BroncoSpace-BILLEE/billee-hardware-2026/BILLEE_Rover_Control_Module_V1/PDB_Engineering_Requirements_and_Design_Guide_Rev_H.docx

BILLEE RCM Power Distribution Board

Engineering Requirements and Design Guide

By Luca Lanzillotta

# Table of Contents

- 1. How to Use This Document
- 2. Locked System Requirements
- 3. System Block Diagram / Architecture
- 4. Part Selection and LCSC/JLCPCB Procurement Table
- 5. Sensor Specifications and I2C Address Map
- 6. RP2350 GPIO Allocation and Software Bindings
- 7. Connection Requirements and PCB Guidelines
- 8. KiCad Schematic Sheet Plan
- 9. Software Implications
- 10. Validation and Bring-Up Plan
- 11. Design Checklist / Assignment Rubric
- 12. Open Verification Items
- 13. References

# 1. How to Use This Document

- Use Sections 2 and 3 to learn the architecture
- Use Sections 4 through 6 to lock parts, sensors, I2C buses, I2C addresses, and GPIO usage.
- Use Sections 7 and 8 as schematic and PCB layout requirements.
- Use Sections 9 and 10 as firmware and bring-up requirements.
- Use Section 11 as the assignment checklist and review rubric.

# 2. Locked System Requirements

## 2.1 Controller Requirement

- The baseline controller shall be a bare Raspberry Pi RP2350A placed directly on the PCB.
- The schematic shall follow the Raspberry Pi RP2350 hardware design guide and the Bronco Space Lab BLVLink hardware v2.0 reference design for RP2350 support circuitry.
- The controller shall expose USB-C for USB device/programming/serial connection to the Jetson.
- The controller shall support Zephyr/F Prime development. The software baseline shall use RP2350/Raspberry Pi Pico 2 Zephyr support as the closest reference target.

## 2.2 Battery Domains

Domain | Nominal input | Input connector | Purpose
Logic/comms | 22.2 V / 6S LiPo | XT90 | Jetson, network switch, 12 V POE antenna, RP2350 housekeeping, aux output
Drivetrain | 14.4 V / 4S LiPo | XT90 | Six independently gated drive motor-controller outputs
Arm/science | 22.2 V / 6S LiPo | XT90/XT90 | Independent ARM and SCIENCE gated outputs

## 2.3 Logic/Comms Requirements

- Jetson, network switch, antenna/POE, and RP2350 housekeeping shall come up automatically when the logic input is present and E-stop is not asserted.
- The POE/antenna module accepts up to 24 V input; it shall be powered directly from the 22.2 V logic rail downstream of its load switch (Note: a freshly charged 6S pack can briefly exceed 24 V (up to ~25.2 V at full charge) before settling under load)
- Logic-side user outputs shall use robust screw terminal blocks/xt60s unless a specific load requires a different connector.
- The aux output shall be a 12 V, always-on regulator output shared with the network switch.
- The RP2350 shall be powered from onboard housekeeping power, not from Jetson USB. Jetson USB is just for serial connection.

## 2.4 Drivetrain Requirements

- The drivetrain shall use six independent high-side MOSFET branches, one per motor-controller output.
- Each drivetrain branch shall use one IPT007N06N high-power N-channel MOSFET.
- Each drivetrain branch shall be power sequenced using one dedicated native RP2350 DRIVE_EN_x GPIO.
- Each DRIVE_EN_x signal shall pass through the GPIO buffer and E-stop gate before reaching the gate-driver input.
- Each drivetrain branch shall include one INA780x I2C current/voltage/power monitor after the MOSFET switch.
- Each drivetrain branch output shall use a horizontal through-hole XT60 connector

## 2.5 Arm/Science Requirements

- The arm/science domain shall be split into two independent rails: ARM and SCIENCE.
- The ARM and SCIENCE rail shall use the same MOSFET + gate driver + INA780x pattern as the drivetrain branches.
- ARM_EN and SCIENCE_EN shall be independent native RP2350 GPIO outputs to power sequence.
- ARM_EN and SCIENCE_EN shall pass through the GPIO buffer and E-stop gate before reaching the gate-driver inputs.

## 2.6 E-stop Requirements

- The PDB shall expose a two-pin screw terminal for the external E-stop/enable switch.
- The switch is normally closed, pulling the ESTOP AND gate input HIGH on idle, this means that when the ESTOP is twisted, it opens, and the integrated pull down resistor pulls the AND gate low.
- When the switch is activated (switch opens), all functional outputs aside from the logic subsystem shall be off. This is so we can still communicate to the system in case of a subsystem fault.
- E_STOP_OK shall be routed to every controlled output enable gate.
- Software high-power-disable exists for Drive/Science/Arms, but logic is never gated.

## 2.7 GPIO and Control Requirements

- All RP2350-controlled output GPIO shall pass through TXS0108EPWR GPIO buffers (used here as straight 3.3V-to-3.3V buffers, VCCA=VCCB) before downstream logic.
- Buffered enable outputs shall pass through SN74LVC08APWR E-stop gates before reaching gate-driver or load-switch control inputs.
- The GPIO buffer and AND gates shall be powered from the 3.3 V housekeeping rail.
- Gate-driver logic inputs shall be compatible with the 3.3 V buffered control chain.
- Gate-driver supply requirements shall be verified from the selected driver datasheet. Do not assume the gate-driver power pin can use 3.3 V unless the selected driver explicitly supports that and still fully enhances the MOSFET.

# 3. System Block Diagram / Architecture

## 3.1 Top-Level System Tree

PDB
|
|-- 22.2 V LOGIC/COMMS INPUT (6S LiPo, XT90)
| |-- E-stop-enabled logic bus
| |-- always-on housekeeping buck -> 3.3 V -> RP2350 + buffers + I2C logic
| |-- always-on protected/regulator path -> Jetson output

| |-- breaking off from before Jetson regulator -> 22.2V output for POE
| |-- always-on 12 V regulator path -> Network switch + Aux, 10 W load
|
|
|-- 14.4 V DRIVETRAIN INPUT (4S LiPo, XT90)
| |-- DRIVE branch 1: gate driver -> IPT007N06N -> INA780x -> horizontal XT60
| |-- DRIVE branch 2: gate driver -> IPT007N06N -> INA780x -> horizontal XT60
| |-- DRIVE branch 3: gate driver -> IPT007N06N -> INA780x -> horizontal XT60
| |-- DRIVE branch 4: gate driver -> IPT007N06N -> INA780x -> horizontal XT60
| |-- DRIVE branch 5: gate driver -> IPT007N06N -> INA780x -> horizontal XT60
| `-- DRIVE branch 6: gate driver -> IPT007N06N -> INA780x -> horizontal XT60
|
`-- 22.2 V ARM/SCIENCE INPUT (6S LiPo, 2xXT90)
|-- ARM rail: gate driver -> IPT007N06N -> INA780x -> horizontal XT60
`-- SCIENCE rail: gate driver -> IPT007N06N -> INA780x -> horizontal XT60

## 3.2 Drivetrain Branch Stack

For each branch x = 1..6:

14.4 V DRIVETRAIN BUS
|
IPT007N06N high-side N-MOSFET
|
INA780x I2C power monitor
|
through-hole XT60 output
|
motor controller

## 3.3 Drivetrain Control Stack

For each branch x = 1..6:

RP2350 DRIVE_EN_x
|
TXS0108EPWR GPIO buffer
|
SN74LVC08APWR AND gate with E_STOP_OK
|
high-side N-MOSFET gate driver input
|
IPT007N06N gate

## 3.4 Arm/Science Stack

22.2 V ARM/SCIENCE INPUT
|
|-- ARM_EN path:
| RP2350 -> buffer -> E-stop gate -> gate driver -> IPT007 -> INA780x -> ARM output
|
`-- SCIENCE_EN path:
RP2350 -> buffer -> E-stop gate -> gate driver -> IPT007 -> INA780x -> SCIENCE output

## 3.5 RP2350 Controller Stack

22.2 V logic input
|
housekeeping regulator -> 3.3 V
|
RP2350A custom controller circuit
|-- external QSPI flash
|-- 12 MHz crystal
|-- USB-C device connector
|-- SWD header
|-- BOOTSEL / RUN buttons or pads
|-- I2C0 -> TCA4307 -> high-current INA780x telemetry
|-- I2C1 -> TCA4307 -> temperature / logic telemetry
`-- native GPIO -> SN74LVC244 -> SN74LVC08 -> gate drivers

## 3.6 E-stop Stack

E-stop screw terminal:
3.3 V pull-up / bias network
|
E_STOP_NODE ---- external 2-prong E-stop switch (normally open) ---- 3.3 V logic rail when actively held closed
|
E_STOP_OK signal
|-- to RP2350 E_STOP_STATUS input
|-- to all SN74LVC08 E-stop gate inputs
`-- to full-system disconnect logic, relay, or approved competition disconnect circuit

# 4. Part Selection and LCSC/JLCPCB Procurement Table

LCSC/JLCPCB part numbers are included where verified during document generation. Stock shall still be checked at design freeze.

Function | MPN | LCSC # | Package / Style | Qty | Requirement
Controller MCU | RP2350A | C42411118 | QFN-60-EP 7x7 | 1 | Baseline controller. Enough GPIO for this architecture.
Optional controller variant | RP2350B | C42415655 | QFN-80-EP 10x10 | 0 | Optional future variant with 48 GPIO. Not baseline; LCSC currently shows not available.
External QSPI flash | W25Q128JVSIQ | C97521 | SOIC-8-208mil | 1 | Baseline external flash for RP2350A. Final capacity may be changed if Zephyr/F Prime image size requires it.
12 MHz crystal | ABM8-272-T3 | C20625731 | SMD3225-4P | 1 | Controller crystal. Match load capacitors to selected crystal and RP2350 reference design.
USB ESD protection | USBLC6-2SC6 | C7519 | SOT-23-6L | 0 | Not required: USB2 carries data only (no VBUS power delivery to a load), and D+/D- are already current-limited by 27ohm series resistors R7/R8. Decision confirmed 2026-08-07; USBLC6-2SC6 removed from baseline.
USB-C receptacle | TYPE-C-31-M-12 | C165948 | USB-C 16-pin | 1 | USB 2.0 device connection to RP2350. Verify footprint and CC resistor wiring.
GPIO buffer | TXS0108EPWR | C17206 | TSSOP-20 | 1 | Buffers all RP2350-controlled enable outputs. 8 total buffer channels; exactly covers DRIVE1-6 + ARM + SCIENCE with zero spare (AUX_22_EN/SPARE_EN removed from baseline).
E-stop AND gate | SN74LVC08APWR | C465737 | TSSOP-14 | 2 | Gates final enables with E_STOP_OK. 8 total AND channels (DRIVE1-6, ARM, SCIENCE). AUX_22_EN/SPARE_EN removed from baseline -- not implemented, no spare channels reserved.
High-side gate driver | ADI LTC7001IMSE#PBF OVLO divider intentionally set for a ~32V trip point to leave margin for a possible future higher-voltage drivetrain battery -- current 4S pack (16.8V max) has no overvoltage trip margin under this setting; accepted tradeoff, see Section 12. INP has an internal 1M-ohm pulldown to GND that holds TGDN toward TS during startup/undriven conditions -- no external MOSFET gate-source pulldown required (residual case: LTC7001 fully unpowered leaves TGDN high-Z, tracked in Section 12). | C581062 | MSOP-10-EP | 8 | One per drivetrain branch, ARM rail, and SCIENCE rail. Verify supply rail and gate drive.
Power MOSFET | IPT007N06N Since this mosfet after about ~8v reaches its “peak” current capabilities, you can set the vcc of this to be on the 12v rail output | C122552 | HSOF-8 | 8 | One per drivetrain branch, ARM rail, and SCIENCE rail.
Schottky Diode | MBR30200CT | C5270548 | TO-220AB | 8 | One per LTC7001 gate-driver channel (all 8: Drive1-6, Arm, Science). Anode to GND, cathode to LTC7001 TS pin (Top Source / switch node) -- clamps negative ringing at turn-off per ADI app guidance. Not output or reverse-polarity protection.
I2C power monitor | INA780BIDEKR | C34740774 | VQFN-15 6x6 | 8 | One per drivetrain branch, ARM rail, and SCIENCE rail.
I2C buffer | TCA4307DGKR | C880333 | VSSOP-8 | 2 min. | One per RP2350 I2C bus segment. Add more only if layout requires more physical segmentation.
Temperature sensor | MCP9808T-E/MS | C129490 | MSOP-8 | 3 min. | Logic, drivetrain, and arm/science thermal zones.
Buck regulator | LT8612EUDE#TRPBF | C462617 | QFN-28-EP 3x6 | 3 | 20v for Jetson, 3.3v for rp2350, and 12v for the POE switch + network switch. Jetson power + network switch + POE will use XT60 connectors (changed from screw terminal blocks).
XT90 Connector | XT60M | C3040689 | Through-hole power | 4 | Four battery inputs, Logic, Science, Arm, Drivetrain
XT60 connector | XT60PW-M | C98732 | Through-hole power | 13 | Six drivetrain outputs, ARM output (2x), SCIENCE output (1x), plus Jetson power, POE switch, network switch, and aux outputs (network switch and aux share one 12V rail but have separate physical XT60 pads) -- moved from KF301 screw terminals.
E-stop terminal | KF301-5.0-2P | C474881 | 2-pin screw term | 1 | Two-pin terminal for pull-to-GND E-stop sw
Screw Terminal Block | KF301-5.0-2P | C474881 | 2-pin screw terminal | 0 | Superseded -- Jetson power, POE switch, and network switch outputs now use XT60 connectors (see XT60 connector row above), not KF301 screw terminals.
Load Switch | TPS1HA08BQPWPRQ1 | C2150178 | HTSSOP-16 (PWP) | 3 | One per LT8612 buck input (3.3V/20V/12V rails), fed from the shared post-INA780-sense 22.2V logic node. Already implemented in schematic (U2/U5/U23); added here to sync BOM with as-built design. ILIM left floating -- confirmed acceptable, uses internal default current limit (~80A). SEL1=15k to GND, SNS=1k to GND selects current-sense mode; LATCH=15k to GND selects auto-retry-after-fault.

Reverse-battery protection diode

BAS21

C181108

SOT-23

1 (shared)

Ground-protection-network diode (DGND) for the TPS1HA08 cluster, per TI's TPS1HA08-Q1 recommended application circuit (Section 9.1, Ground Protection Network): placed in series between the TPS1HA08 devices' common GND reference and board GND (NOT in series with VBB), so only the eFuses' own quiescent/control current needs blocking during a reverse-battery event, not the full load current. Multiple high-side switches may share one DGND network -- U2/U5/U23 can share a single BAS21. Add RGND (4.7k-ohm typical, size against IGND abs-max rating) in parallel with DGND if any of the three drives an inductive load. NOTE: device GND will be offset from microcontroller GND by the diode's forward drop when current flows -- confirm all EN/DIA_EN/SNS/ST/SEL1/SEL2/LATCH control-pin interfaces to the RP2350 have adequate RPROT-style series resistance (15k-ohm typical per TI) for this offset. NOT YET IMPLEMENTED IN SCHEMATIC as of 2026-08-07 -- new requirement, see Section 12.

# 5. Sensor Specifications and I2C Address Map

## 5.1 I2C Topology Requirement

- The design shall use onboard TCA4307 I2C buffers.
- The RP2350 shall use both I2C controllers in the baseline design.
- TCA4307 devices are buffers, not multiplexers. They do not solve duplicate I2C addresses.
- All devices sharing a logical I2C bus shall have unique addresses.
- High-current telemetry shall be physically separated from local controller and temperature sensors when practical.
- No GPIO expander shall be placed on the required baseline I2C bus.

Recommended I2C allocation:

RP2350 I2C0 - high-current telemetry bus
`-- TCA4307 buffer: drivetrain + arm/science segment

|-- INA780x LOGIC
|-- INA780x DRIVE1
|-- INA780x DRIVE2
|-- INA780x DRIVE3
|-- INA780x DRIVE4
|-- INA780x DRIVE5
|-- INA780x DRIVE6
|-- INA780x ARM
`-- INA780x SCIENCE

RP2350 I2C1 - local/logic telemetry bus
`-- TCA4307 buffer: logic/temp segment
|-- MCP9808 logic zone
|-- MCP9808 drivetrain zone
`-- MCP9808 arm/science zone

## 5.2 Target I2C Address Map

Bus | Device | 7-bit address | Address strap
I2C0 | INA780x DRIVE1 | 0x40 | A1=GND, A0=GND
I2C0 | INA780x DRIVE2 | 0x41 | A1=GND, A0=VS
I2C0 | INA780x DRIVE3 | 0x43 | A1=GND, A0=SCL
I2C0 | INA780x DRIVE4 | 0x44 | A1=VS, A0=GND
I2C0 | INA780x DRIVE5 | 0x45 | A1=VS, A0=VS
I2C0 | INA780x DRIVE6 | 0x47 | A1=VS, A0=SCL
I2C0 | INA780x ARM | 0x4C | A1=SCL, A0=GND
I2C0 | INA780x SCIENCE | 0x4D | A1=SCL, A0=VS
I2C0 | INA780x LOGIC | 0x4F | A1=SCL, A0=SCL
I2C1 | MCP9808 LOGIC_TEMP | 0x18 | A2=0, A1=0, A0=0
I2C1 | MCP9808 DRIVE_TEMP | 0x19 | A2=0, A1=0, A0=1
I2C1 | MCP9808 ARM_SCI_TEMP | 0x1A | A2=0, A1=1, A0=0

- INA780x addresses using SDA straps shall be avoided unless explicitly required, because TI notes an additional hold-time requirement when SDA is used as an address strap.
- The firmware shall probe all expected addresses at boot and fail safe if any required monitor is missing.

## 5.3 Required Telemetry Values

- Per drivetrain branch: voltage, current, power, alert/fault status.
- Computed drivetrain total: sum of six branch currents and sum of six branch powers.
- ARM rail: voltage, current, power, alert/fault status.
- SCIENCE rail: voltage, current, power, alert/fault status.
- Temperature: logic regulator zone, drivetrain MOSFET/INA zone, arm/science MOSFET/INA zone.
- E-stop status: asserted/not asserted.
- GPIO status: commanded state and final allowed state for each controlled output.

# 6. RP2350 GPIO Allocation and Software Bindings

## 6.1 GPIO Capacity Requirement

- The baseline design shall use native RP2350 GPIO only.
- The RP2350A QFN-60 package exposes enough GPIO for all required enable, I2C, E-stop, debug, and status signals.
- GPIO expanders shall not be used for required enable control.
- If a future revision adds enough fault inputs to exceed native GPIO capacity, add a GPIO expander only for noncritical status inputs, not for enable lines.

## 6.2 Proposed Native GPIO Map

RP2350 pin | Net name | Function
GPIO0 | I2C0_SDA | High-current telemetry bus SDA
GPIO1 | I2C0_SCL | High-current telemetry bus SCL
GPIO2 | I2C1_SDA | Logic/temp telemetry bus SDA
GPIO3 | I2C1_SCL | Logic/temp telemetry bus SCL
GPIO4 | DRIVE_EN_1 | Native output -> buffer -> E-stop gate -> gate driver
GPIO5 | DRIVE_EN_2 | Native output -> buffer -> E-stop gate -> gate driver
GPIO6 | DRIVE_EN_3 | Native output -> buffer -> E-stop gate -> gate driver
GPIO7 | DRIVE_EN_4 | Native output -> buffer -> E-stop gate -> gate driver
GPIO8 | DRIVE_EN_5 | Native output -> buffer -> E-stop gate -> gate driver
GPIO9 | DRIVE_EN_6 | Native output -> buffer -> E-stop gate -> gate driver
GPIO10 | ARM_EN | Native output -> buffer -> E-stop gate -> gate driver
GPIO11 | SCIENCE_EN | Native output -> buffer -> E-stop gate -> gate driver
GPIO12 | E_STOP_STATUS | ESTOP GPIO Monitor (corrected from GPIO13 in Rev G)
GPIO13 | Broken out on DF11 Header
GPIO14 | Broken out on DF11 Header
GPIO15 | Broken out on DF11 Header
GPIO16 | Broken out on DF11 Header
GPIO17 | Broken out on DF11 Header
GPIO18 | Broken out on DF11 Header
GPIO19 | Broken out on DF11 Header
GPIO20 | Broken out on DF11 Header
GPIO21 | Broken out on DF11 Header
GPIO22 | Broken out on DF11 Header
GPIO23 | Broken out on DF11 Header
GPIO24 | Broken out on DF11 Header
GPIO25 | Broken out on DF11 Header
GPIO26 | Broken out on DF11 Header
GPIO27 | Broken out on DF11 Header
GPIO28 | NA
GPIO29 | NA

## 6.3 Buffer and AND Gate Channel Use

Signal | TXS0108E channel | SN74LVC08 channel | Final destination
DRIVE_EN_1 | BUF1-A1 | AND1-1 | Gate driver DRIVE1 input
DRIVE_EN_2 | BUF1-A2 | AND1-2 | Gate driver DRIVE2 input
DRIVE_EN_3 | BUF1-A3 | AND1-3 | Gate driver DRIVE3 input
DRIVE_EN_4 | BUF1-A4 | AND1-4 | Gate driver DRIVE4 input
DRIVE_EN_5 | BUF1-B1 | AND2-1 | Gate driver DRIVE5 input
DRIVE_EN_6 | BUF1-B2 | AND2-2 | Gate driver DRIVE6 input
ARM_EN | BUF1-B3 | AND2-3 | Gate driver ARM input
SCIENCE_EN | BUF1-B4 | AND2-4 | Gate driver SCIENCE input

- Tie unused SN74LVC244 inputs to a defined state.
- Disable unused SN74LVC244 outputs or route them to labeled test pads.
- Tie unused SN74LVC08 inputs to GND. Do not leave CMOS inputs floating.
- All final enable lines shall have local pulldowns so power stages default OFF when logic is unpowered.

## 6.4 Zephyr / F Prime Binding Names

TBD

# 7. Connection Requirements and PCB Guidelines

## 7.1 Manufacturing Baseline

Parameter | Requirement
Layer count | 4-layer minimum. 6-layer preferred if budget allows.
Copper weight | 2 oz outer layers minimum for high-current sections. Use heavier copper or reinforcement if thermal/current review requires it.
Board size | Any size is acceptable if the board fits within at most one-third of the rover footprint.
High-current connectors | Use horizontal through-hole XT60 for drivetrain outputs and high-current ARM/SCIENCE outputs unless explicitly approved otherwise.
Logic outputs | Use screw terminal blocks or robust terminal connectors. Do not use small logic terminals for motor power.
Assembly | Do not use thermal reliefs on high-current MOSFET, INA780x high-current, or XT60 power pads unless assembly review requires it.

## 7.2 Recommended Stackup

4-layer baseline:
L1: components, local high-current pours, switching/gate-driver components
L2: solid GND plane
L3: power planes / high-current distribution zones / 3.3 V where needed
L4: signals, low-current routing, secondary pours

6-layer preferred:
L1: components + local high-current routing
L2: solid GND
L3: high-current power planes / 22.2 V / 14.4 V zones
L4: 3.3 V / quiet logic / sensor routing
L5: solid GND
L6: signals + secondary power pours

## 7.3 Routing Rules

Net class | Starting rule
USB D+/D- | Route as controlled-impedance differential pair. Keep stubs short. No dedicated USB ESD part in baseline (see Section 4 rationale) -- keep this net away from connector-shell/ESD-exposure paths as good practice regardless.
QSPI flash | Short routes, length matched only as needed by reference design. Keep away from high-current switching copper.
Crystal | Place next to RP2350. Keep loop tiny. Guard with ground. Follow reference design load-cap values.
GPIO enables | 6-8 mil minimum. Route from RP2350 to buffer, then to AND gate, then to gate driver input.
I2C | 6-8 mil minimum. Pullups on buffered side as required. Keep high-current I2C physically separated from logic bus.
Gate drive | Short, direct, local to MOSFET. LTC7001 TGDN ties directly to gate (fast turn-off); TGUP feeds gate through a 200k-ohm resistor to control turn-on inrush -- this is ADI's recommended LTC7001 topology, not a generic 5-10 ohm gate resistor. No external gate-source pulldown required (LTC7001 INP has an internal 1M-ohm pulldown to GND holding TGDN toward TS); residual risk if LTC7001 itself loses VCC entirely is tracked in Section 12.
INA780x current path | Treat as power copper, not signal. Follow TI layout. Use short, wide pours and thermal copper.
Motor power | Wide pours or busbar-like copper. Use 2 oz copper minimum. No thin traces.

## 7.4 Current Path Rules

- Calculate I^2R loss for every IPT007N06N branch using worst-case branch current.
- Calculate heat in the INA780x package and copper for every monitored branch.
- Place MOSFET, gate driver, INA780x, and XT60 for each branch in a physically compact power cell.
- Keep current loops short and wide.
- Do not route USB, QSPI, crystal, or I2C under or beside motor-current hot paths unless separated by solid ground and distance.
- Provide test points for every enable, final gated enable, gate-driver input, E_STOP_NODE, I2C bus, and all major rails.

# 9. Software Implications

## 9.1 Firmware Baseline

- Firmware shall support Zephyr on RP2350A or a custom board target derived from Raspberry Pi Pico 2 / RP2350A support.
- F Prime shall run above the board support layer if used. F Prime components shall not bypass safety state management.
- All enable GPIO shall default OFF at reset.
- Firmware shall read E_STOP_STATUS before enabling any controlled rail.
- Firmware shall not attempt to override E-stop gating.

## 9.2 Required Firmware Modules

Module | Required behavior
TBD

## 9.3 Required Jetson Command Set

TBD

# 10. Validation and Bring-Up Plan

1. Bring up RP2350 controller alone from current-limited bench supply.
2. Verify USB-C enumeration and bootloader access.
3. Verify SWD programming and debug access.
4. Run GPIO self-test into buffers and AND gates with no power stages populated if possible.
5. Verify E_STOP_NODE reads LOW by default and whenever the switch is open/released, and HIGH only while the switch is actively held closed.
6. Verify every final enable is forced low whenever the E-stop switch is not actively held closed (released, disconnected, or wiring fault).
7. Bring up I2C0 with no high-current load. Probe all INA780x addresses.
8. Bring up I2C1 and probe all MCP9808 addresses.
9. Populate one drivetrain branch and test gate-driver/MOSFET switching with current-limited load.
10. Validate INA780x readings against bench supply/current meter.
11. Repeat for all drivetrain branches.
12. Validate ARM and SCIENCE rails separately.
13. Run thermal test at expected continuous current.
14. Run transient/inrush test with motor controller attached.
15. Only after branch validation, connect real motors and verify software sequencing.

# 11. Design Checklist / Assignment Rubric

## 11.1 Procurement / Library Checklist

- Every LCSC part number in Section 4 has been rechecked at design freeze.
- Every symbol exists in KiCad and matches the datasheet pinout.
- Every footprint exists in KiCad and matches the manufacturer land pattern.
- Every high-current connector footprint has been checked against the physical part.
- RP2350A footprint, exposed pad, USB, flash, crystal, and power pins have been checked against the Raspberry Pi reference design.

## 11.2 Schematic Checklist

- RP2350A support circuit follows official/reference schematic.
- USB-C CC resistors, ESD, D+/D- routing, and power behavior are correct.
- QSPI flash and crystal are correct and placed on the controller sheet.
- No MCP23017 or GPIO expander exists in the required control path.
- All enable outputs pass through SN74LVC244 before SN74LVC08 gates.
- All E-stop gated enables have pulldowns and safe default states.
- Every INA780x has unique address straps matching Section 5.
- Every TCA4307 has correct pullups, EN/READY handling, and test points.
- Every gate driver has verified logic input and verified power supply connections.
- Every MOSFET has gate resistor, gate-source pulldown, and optional gate-source clamp if required.

## 11.3 PCB Checklist

- High-current branch cells are physically compact and repeated consistently.
- MOSFETs, INA780x packages, and XT60 connectors use wide copper and thermal copper.
- USB, QSPI, crystal, and I2C are routed away from high-current paths.
- Ground plane is continuous under RP2350, USB, QSPI, crystal, and I2C.
- All connectors have readable silkscreen labels and polarity markings.
- Test points exist for all rails, E-stop, I2C, enable signals, final enables, and fault summaries.

## 11.4 Software Checklist

- Zephyr board definition or F Prime deployment matches the GPIO/I2C names in Section 6.
- All rails default OFF except fixed always-on paths when not E-stopped.
- Firmware refuses to enable outputs when E-stop is asserted.
- Firmware probes all I2C devices and reports missing sensors.
- Firmware computes drivetrain total current and power from branch telemetry.
- Firmware implements high power disable command.
- Telemetry packet includes rail states, voltage, current, power, temperature, fault state, and E-stop state.

# 12. Open Verification Items

Open item | Action required
IPT007 thermal margin | Calculate I^2R loss for expected branch current and verify copper/thermal design. Do not trust package headline current rating alone.
INA780x thermal margin | Verify each branch current profile is inside INA780x measurement and thermal envelope.
RP2350 reference design merge | Compare final controller sheet against Raspberry Pi official minimal design and the Bronco Space Lab BLVLink hardware v2.0 reference design before PCB routing.
Reverse-battery protection -- drivetrain/arm/science | Drive/Arm/Science wont have reverse circuit protection

# 13. References

Reference | Used for
Raspberry Pi RP2350 product brief | Confirms RP2350 package variants, 30/48 GPIO variants, dual Arm/RISC-V architecture, PIO count.
Raspberry Pi Hardware Design with RP2350 | Controller reference design for RP2350A/RP2350B minimal boards, flash, crystal, USB, SWD, BOOTSEL/RUN.
Bronco Space Lab BLVLink hardware v2.0 GitHub repository (https://github.com/BroncoSpace-Lab/BLVLink-hardware-v2.0) | RP2350 reference design cross-check. Use this repository to compare the custom controller sheet against known RP2350 support circuitry, including MCU schematic structure, USB, flash, crystal, SWD, BOOTSEL/RUN, and KiCad project organization before PCB routing.
Zephyr Raspberry Pi Pico 2 documentation | Closest Zephyr RP2350A board target and feature reference.
TI INA780B datasheet | I2C power monitor specs, address table, current/voltage/power telemetry, layout requirements.
Infineon IPT007N06N datasheet / LCSC listing | MOSFET voltage, package, RDS(on), current class, gate charge.
ADI LTC7001 datasheet / LCSC listing | High-side N-MOSFET driver behavior and supply requirements.
TI SN74LVC244A and SN74LVC08A datasheets / LCSC listings | 3.3 V GPIO buffer and E-stop AND gate logic.
TI TCA4307 datasheet / LCSC listing | I2C buffer, bus recovery, hot-swap/buffering behavior.
Microchip MCP9808 datasheet / LCSC listing | I2C temperature sensor behavior and address options.
Abracon ABM8-272-T3 listing | 12 MHz crystal selected for RP2350 reference-design-compatible clock circuit; LCSC C20625731.
TI TPS1HA08-Q1 datasheet | Smart high-side eFuse ahead of each LT8612 buck input. Ground-protection-network application circuit (Section 9.1) is the basis for the BAS21 reverse-battery-protection requirement.
Nexperia BAS21 datasheet | Small-signal switching diode used as DGND in the TPS1HA08 ground-protection network.

PDB Engineering Requirements and Design Guide -- Rev H | Page 1 of 2
