BroncoSpace-BILLEE/billee-hardware-2026/BILLEE_Rover_Control_Module_V1/sims/DrivetrainSim/DrivetrainSim.asc

A1: and; Vhigh=3.0
Aux_Power: voltage; 12V
C1: cap; 4.7µ; IC=12
C2: cap; 0.47µ
C3: cap; 10µ
D1: diode
DriveBatt: voltage; 14.4V
ESTOP: voltage; {X}
GPIO: voltage; 3.3V
R1: res; 866k
R2: res; 34k
R3: res; 150k
R4: res; 200k
R5: res; 10
R6: res; 10k
R7: res; 10
Rgate: res; 0
U1: LTC7001
U2: IPT007N06N
Named nets: 0, Drive1_Out
Set to 0V to turn off the AND Gate
.tran 0 3 0 50 uic
.options trtol=7
.STEP PARAM X LIST 0V 3.3V
AND gate is a stand in replacement for the SN74LVC08APWR, which outputs 3V @24mA
