BroncoSpace-BILLEE/billee-hardware-2026/BILLEE_Rover_Control_Module_V1/sims/NetworkSwitchAuxPowerSim/NetworkAuxPowerSim.asc

C1: cap; 220n
C2: cap; 4.7µ
C3: cap; 10n
C4: cap; 1µ
C5: cap; 10p
C7: cap; 10µ
C8: cap; 10µ
C9: cap; 0.1µ
L1: ind; 10µ; Rser=1m
R1: res; 33K
R2: res; 10K
R3: res; 1Meg
R4: res; 15K
R5: res; 4.7k
R6: res; 15K
R7: res; 1Meg
R8: res; 200K
R9: res; 10k
R10: res; 1Meg
R11: res; 88.7k
R12: res; 41.2k
R13: res; 15k
R14: res; 1Meg
R15: res; 1Meg
R16: res; 10k
U1: TPS1HB08B_SW
U2: LT8612_AVG
U3: BAS316
V1: voltage; {X}
Named nets: 0, Vout
.tran 0 3 0 uic
.lib LT8612_AVG.lib
.lib TPS1HB08B_SW.lib
.STEP PARAM X LIST 22.2V 21V 26V 20V -20V
Expect high overshoot as LT8612 is approximated.
Vendor labeled sim does not have this issue.
Should be 12V
