BroncoSpace-BILLEE/billee-hardware-2026/BILLEE_Rover_Control_Module_V1/sims/JetsonPowerSim/JetsonPwr.asc

C1: cap; 220n
C2: cap; 4.7�
C3: cap; 1�
C4: cap; 1�
C5: cap; 10p
C7: cap; 47�
C8: cap; 47�
C9: cap; 0.1�
L1: ind; 33�; Rser=1m
R1: res; 33K
R2: res; 10K
R3: res; 1Meg
R4: res; 15K
R5: res; 4.7k
R6: res; 15K
R7: res; 1Meg
R8: res; 200K
R9: res; 10k
R10: res; 196k
R11: res; 10k
R12: res; 110k
R13: res; 15k
R14: res; 1Meg
R15: res; 1Meg
U1: TPS1HB08B_SW
U2: LT8612_AVG
U3: BAS316
V1: voltage; 22.2V
Named nets: 0, Vout
.tran 0 3 0 uic
.lib LT8612_AVG.lib
.lib TPS1HB08B_SW.lib
