BroncoSpace-BILLEE/billee-hardware-2026/BILLEE_Science_Control_Module_V1/BILLEE_Science_Control_Module_V1/BILLEE_Science_Control_Module_V1.kicad_pcb

## KiCad design Hardware/KiCad/Robot/Robot.kicad_sch

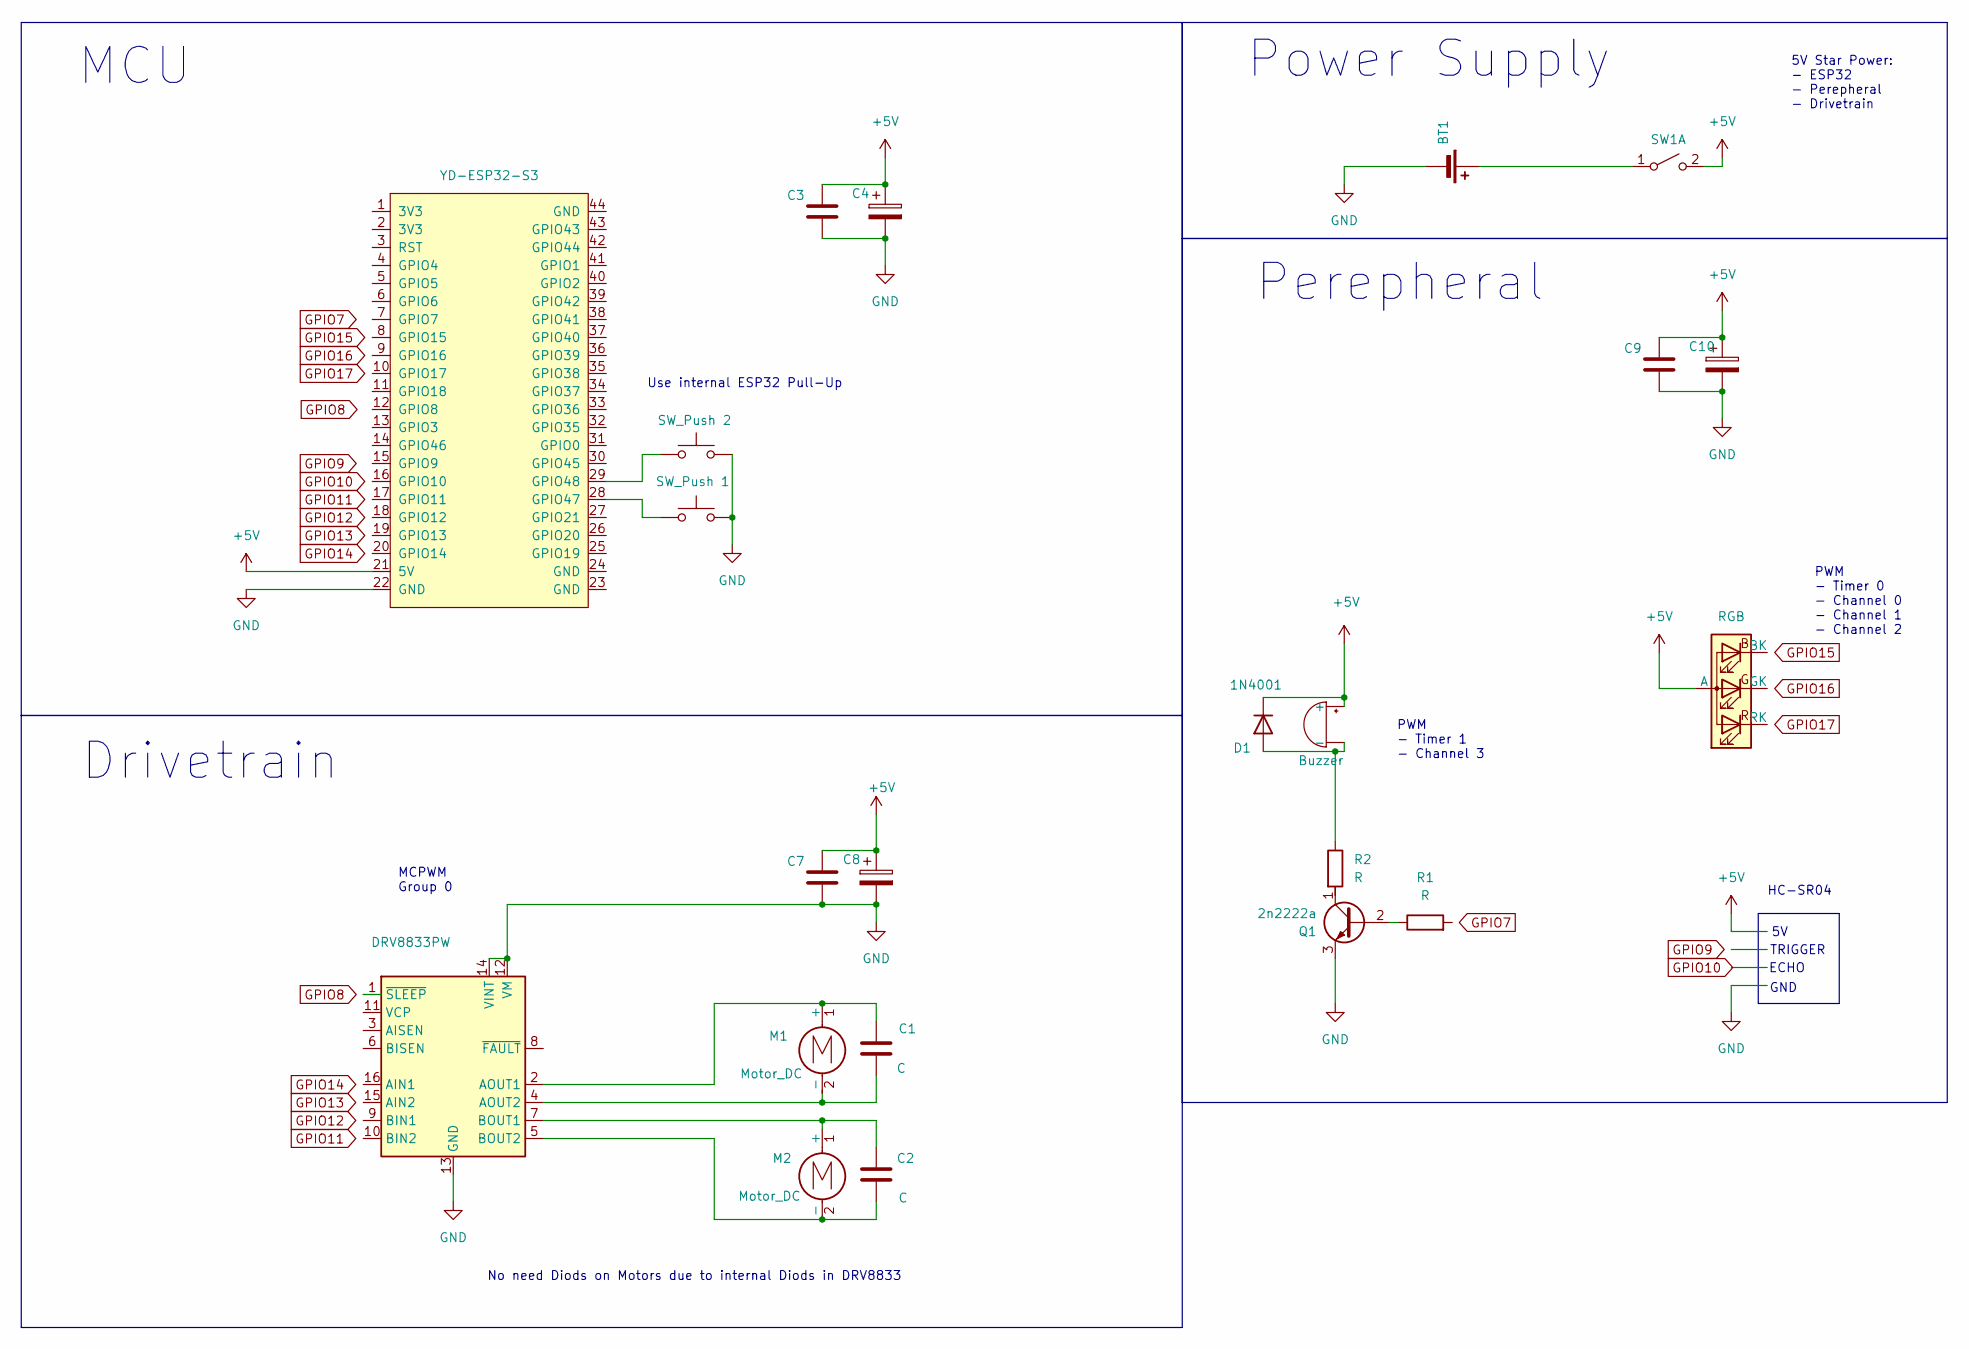
[picture p1: schematic Robot.kicad_sch]

Parts:
BT1: (no value)
BZ1: Buzzer
C1, C2: C
C3, C7, C9: (no value)
C4, C8, C10: C_Polarized
D1: 1N4001; D_DO-41_SOD81_P10.16mm_Horizontal
M1, M2: Motor_DC
Q1: 2n2222a; TO-92_Inline
R1, R2: R
SW1: (no value)
SW2: SW_Push 2
U1: YD-ESP32-S3
U2: DRV8833PW; TSSOP-16_4.4x5mm_P0.65mm

Connections:
+5V: BZ1.1 (+), C3.1, C4.1, C7.1, C8.1, C9.1, C10.1, D1.1 (A), SW1.2, U1.21 (5V)
GND: BT1.2 (-), C3.2, C4.2, C7.2, C8.2, C9.2, C10.2, Q1.3 (E), SW1.2, SW2.2, U1.22 (GND), U2.12 (VM), U2.13 (GND), U2.14 (VINT)
unnamed: BT1.1 (+), SW1.1
unnamed: BZ1.2 (-), D1.2 (RK), R2.1
unnamed: C1.1, M1.1 (+), U2.2 (AOUT1)
unnamed: C1.2, M1.2 (-), U2.4 (AOUT2)
unnamed: C2.1, M2.1 (+), U2.7 (BOUT1)
unnamed: C2.2, M2.2 (-), U2.5 (BOUT2)
unnamed: Q1.2 (B), R1.1
unnamed: SW1.1, U1.28 (GPIO47)
unnamed: SW2.1, U1.29 (GPIO48)

Notes on the sheet:
Power Supply
TRIGGER
No need Diods on Motors due to internal Diods in DRV8833
HC-SR04
Use internal ESP32 Pull-Up
5V Star Power: - ESP32 - Perepheral - Drivetrain
MCU
PWM - Timer 1 - Channel 3
ECHO
PWM - Timer 0 - Channel 0 - Channel 1 - Channel 2
MCPWM Group 0
GND
Drivetrain
Perepheral
