BroncoSpace-BILLEE/billee-hardware-2026/(commit log)

2026-07-03 Initial Commit
    V1 Schematic and RevG Document
    [BILLEE_Rover_Control_Module_V1.kicad_pcb, BILLEE_Rover_Control_Module_V1.kicad_sch]
2026-07-06 Verified more docs
    [BILLEE_Rover_Control_Module_V1.kicad_sch, inputs_estop.kicad_sch]
2026-07-06 Symbols and footprints imported
    [pyvenv.cfg]
2026-07-06 Updated Doc with new I2C Device and added ESTOP subsystem to Schematic
    [BILLEE_Rover_Control_Module_V1.kicad_sch, inputs_estop.kicad_sch, pyvenv.cfg]
2026-07-17 RP 2350A added
    Added the RP2350A as a hierarchal sheet and followed the official RP2350A datasheet to do so.
    [BILLEE_Rover_Control_Module_V1.kicad_sch, untitled.kicad_sch]
2026-07-22 Lots of Goodies. Getting the ball rolling
    Merged Jasons changed on starting the RP2350.
    I refactored his symbols, fixed some connections, and started implementing the buffers as well as all the necessary GPIO connections.
    [BILLEE_Rover_Control_Module_V1.kicad_sch, estop.kicad_sch, power.kicad_sch, pyvenv.cfg, untitled.kicad_sch]
2026-07-25 Implemented Logic Subsystem
    Implemented all of the Logic subsystem, missing reverse circuit protection.
    [BILLEE_Rover_Control_Module_V1.kicad_sch, estop.kicad_sch, power.kicad_sch, untitled.kicad_sch]
2026-07-26 Updated filename
    [BILLEE_Rover_Control_Module_V1.kicad_sch, mcurp2350.kicad_sch]
2026-07-26 Updated Firmware to running state and Fixed Missing pins on RP2350
    [mcurp2350.kicad_sch]
2026-07-26 Minor updates
    [mcurp2350.kicad_sch]
2026-07-27 Firmware Updated
    INAManager, MCPManager, FPManager. Remove resistor on ESTOP BUFFER.
    FPManager still needs a state machine to technically do this correctly, I dont want to rely too much on the cpp implementation
    [estop.kicad_sch, mcurp2350.kicad_sch]
2026-07-29 temporary push
    Added the gate driver and its mosfet started the set up, but yet to confirm its connections and values. will do when i get home
    [BILLEE_Rover_Control_Module_V1.kicad_sch, gate driver + mosfet.kicad_sch]
2026-08-02 WIP Checkpoint
    [BILLEE_Rover_Control_Module_V1.kicad_sch, estop.kicad_sch, gate driver + mosfet.kicad_sch, mcurp2350.kicad_sch, power.kicad_sch]
2026-08-02 Goodies
    Updated all schematics
    [BILLEE_Rover_Control_Module_V1.kicad_sch, estop.kicad_sch, mcurp2350.kicad_sch, power.kicad_sch]
2026-08-02 small goodies
    [BILLEE_Rover_Control_Module_V1.kicad_sch]
2026-08-02 more goodies
    [BILLEE_Rover_Control_Module_V1.kicad_sch, mcurp2350.kicad_sch, power.kicad_sch]
2026-08-05 Updated for schematic review by claude
    [BILLEE_Rover_Control_Module_V1.kicad_sch, estop.kicad_sch, mcurp2350.kicad_sch, power.kicad_sch]
2026-08-05 Applied first round of Claude review suggestions.
    Updated UVLO and OVLO guidelines.
    Updated symbol pin mappings and net attributes. Preparing for layout
    [estop.kicad_sch, mcurp2350.kicad_sch, power.kicad_sch]
2026-08-08 Replaced GPIO buffer. Need to add reverse circuit protection. Still trying to figure out what to use
    [BILLEE_Rover_Control_Module_V1.kicad_sch, mcurp2350.kicad_sch, power.kicad_sch]
2026-08-08 More goodies.
    Did a review with claude and patched a lot of missng things. Updated RCP for LOGIC and more.
    [BILLEE_Rover_Control_Module_V1.kicad_sch, estop.kicad_sch, power.kicad_sch]
2026-08-08 Biggus Goodies
    [BILLEE_Rover_Control_Module_V1.kicad_sch, estop.kicad_sch, gate driver + mosfet.kicad_sch, inputs_estop.kicad_sch, mcurp2350.kicad_sch, power.kicad_sch, untitled.kicad_sch]
2026-08-08 Schematic Fixed in NO RCP yet
    [estop.kicad_sch, mcurp2350.kicad_sch, power.kicad_sch]
2026-08-08 Updated footprint selection
    Still missing the four inductors for the regulators, two of them can be poached from scales
    [estop.kicad_sch, mcurp2350.kicad_sch, power.kicad_sch]
2026-08-08 Updated footprints. I think schematic is officially finished.
    [estop.kicad_sch, mcurp2350.kicad_sch, power.kicad_sch]
2026-08-08 Updated reference designators. Schematic Complete
    Not including RCP for Drivetrain/Arm/Science
    [estop.kicad_sch, mcurp2350.kicad_sch, power.kicad_sch]
2026-08-09 begun layout
    [BILLEE_Rover_Control_Module_V1.kicad_pcb, BILLEE_Rover_Control_Module_V1.kicad_sch]
2026-08-09 added wiring references
    [BILLEE_Rover_Control_Module_V1.kicad_sch]
2026-08-10 continuing layout
    [BILLEE_Rover_Control_Module_V1.kicad_pcb, power.kicad_sch]
2026-08-10 Layout Cont.
    [BILLEE_Rover_Control_Module_V1.kicad_pcb, mcurp2350.kicad_sch, power.kicad_sch]
2026-08-11 Layout! 🍋
    [BILLEE_Rover_Control_Module_V1.kicad_pcb, estop.kicad_sch, power.kicad_sch]
2026-08-12 More Layout :)
    [BILLEE_Rover_Control_Module_V1.kicad_pcb]
2026-08-13 More layout!
    [BILLEE_Rover_Control_Module_V1.kicad_pcb, estop.kicad_sch]
2026-08-13 Jenson Power SIM
    LTspice simulation of the Jenson
2026-08-13 Sims 😫
2026-08-14 Fixed board outline
    [BILLEE_Rover_Control_Module_V1.kicad_pcb]
2026-08-17 More layout :tired_face:
    [BILLEE_Rover_Control_Module_V1.kicad_pcb, estop.kicad_sch, mcurp2350.kicad_sch, power.kicad_sch]
2026-08-17 Resatarted Layout for something a little bit cleaner.
    [BILLEE_Rover_Control_Module_V1.kicad_pcb, power.kicad_sch]
2026-08-18 Routing continued
    [BILLEE_Rover_Control_Module_V1.kicad_pcb]
2026-08-18 More layout
    [BILLEE_Rover_Control_Module_V1.kicad_pcb]
2026-08-19 Routing complete I think
    [BILLEE_Rover_Control_Module_V1.kicad_pcb, power.kicad_sch]
2026-08-19 Done I think
    [BILLEE_Rover_Control_Module_V1.kicad_pcb, estop.kicad_sch, power.kicad_sch]
2026-08-19 Done + Gerbers
    Needs a full schematic + PCB review
    Cost estimate for 2 boards is about 850
    [BILLEE_Rover_Control_Module_V1-CuBottom.gbr, BILLEE_Rover_Control_Module_V1-CuIn1.gbr, BILLEE_Rover_Control_Module_V1-CuIn2.gbr, BILLEE_Rover_Control_Module_V1-CuTop.gbr, BILLEE_Rover_Control_Module_V1-EdgeCuts.gbr, BILLEE_Rover_Control_Module_V1-MaskBottom.gbr, BILLEE_Rover_Control_Module_V1-MaskTop.gbr, BILLEE_Rover_Control_Module_V1-NPTH.drl]
2026-08-20 Updated Gerbers and Sims confirmed to be matched
    [BILLEE_Rover_Control_Module_V1-CuBottom.gbr, BILLEE_Rover_Control_Module_V1-CuIn1.gbr, BILLEE_Rover_Control_Module_V1-CuIn2.gbr, BILLEE_Rover_Control_Module_V1-CuTop.gbr, BILLEE_Rover_Control_Module_V1-EdgeCuts.gbr, BILLEE_Rover_Control_Module_V1-MaskBottom.gbr, BILLEE_Rover_Control_Module_V1-MaskTop.gbr, BILLEE_Rover_Control_Module_V1-NPTH.drl]
2026-08-21 Updated schematic documentation
    [BILLEE_Rover_Control_Module_V1.kicad_sch]
2026-08-21 Fixed Manufacturing Problems and updated BOM and Gerbers
    [BILLEE_Rover_Control_Module_V1-CuBottom.gbr, BILLEE_Rover_Control_Module_V1-CuIn1.gbr, BILLEE_Rover_Control_Module_V1-CuIn2.gbr, BILLEE_Rover_Control_Module_V1-CuTop.gbr, BILLEE_Rover_Control_Module_V1-EdgeCuts.gbr, BILLEE_Rover_Control_Module_V1-MaskBottom.gbr, BILLEE_Rover_Control_Module_V1-MaskTop.gbr, BILLEE_Rover_Control_Module_V1-NPTH.drl]
2026-08-22 Fixed small Annular ring problem
    [BILLEE_Rover_Control_Module_V1.kicad_pcb]
2026-08-22 Fixed USB hole problem. New Gerbers + BOM
    [BILLEE_Rover_Control_Module_V1-CuBottom.gbr, BILLEE_Rover_Control_Module_V1-CuIn1.gbr, BILLEE_Rover_Control_Module_V1-CuIn2.gbr, BILLEE_Rover_Control_Module_V1-CuTop.gbr, BILLEE_Rover_Control_Module_V1-EdgeCuts.gbr, BILLEE_Rover_Control_Module_V1-MaskBottom.gbr, BILLEE_Rover_Control_Module_V1-MaskTop.gbr, BILLEE_Rover_Control_Module_V1-NPTH.drl]
2026-08-22 Fixed little things. Updated Gerbers
    [BILLEE_Rover_Control_Module_V1-CuBottom.gbr, BILLEE_Rover_Control_Module_V1-CuIn1.gbr, BILLEE_Rover_Control_Module_V1-CuIn2.gbr, BILLEE_Rover_Control_Module_V1-CuTop.gbr, BILLEE_Rover_Control_Module_V1-EdgeCuts.gbr, BILLEE_Rover_Control_Module_V1-MaskBottom.gbr, BILLEE_Rover_Control_Module_V1-MaskTop.gbr, BILLEE_Rover_Control_Module_V1-NPTH.drl]
2026-08-24 Updated links for eth sw and poe
    [BILLEE_Rover_Control_Module_V1.kicad_sch]
2026-08-24 Applied Jason Suarez Feeback
    Updated Inductor value from 1.8u to 8.2u for correct ringing match. Regenerated Gerbers and BOM
    [BILLEE_Rover_Control_Module_V1-CuBottom.gbr, BILLEE_Rover_Control_Module_V1-CuIn1.gbr, BILLEE_Rover_Control_Module_V1-CuIn2.gbr, BILLEE_Rover_Control_Module_V1-CuTop.gbr, BILLEE_Rover_Control_Module_V1-EdgeCuts.gbr, BILLEE_Rover_Control_Module_V1-MaskBottom.gbr, BILLEE_Rover_Control_Module_V1-MaskTop.gbr, BILLEE_Rover_Control_Module_V1-NPTH.drl]
2026-08-27 Updated some values, updated their sims. Ready for a Claude Pass.
    [BILLEE_Rover_Control_Module_V1-CuBottom.gbr, BILLEE_Rover_Control_Module_V1-CuIn1.gbr, BILLEE_Rover_Control_Module_V1-CuIn2.gbr, BILLEE_Rover_Control_Module_V1-CuTop.gbr, BILLEE_Rover_Control_Module_V1-EdgeCuts.gbr, BILLEE_Rover_Control_Module_V1-MaskBottom.gbr, BILLEE_Rover_Control_Module_V1-MaskTop.gbr, BILLEE_Rover_Control_Module_V1-NPTH.drl]
2026-08-27 Updated with Claude Notes. Checking again.
    [BILLEE_Rover_Control_Module_V1.kicad_pcb, estop.kicad_sch, mcurp2350.kicad_sch, power.kicad_sch]
2026-08-27 Pushing Good Gerbers. BOM and CPL
    [BILLEE_Rover_Control_Module_V1-CuBottom.gbr, BILLEE_Rover_Control_Module_V1-CuIn1.gbr, BILLEE_Rover_Control_Module_V1-CuIn2.gbr, BILLEE_Rover_Control_Module_V1-CuTop.gbr, BILLEE_Rover_Control_Module_V1-EdgeCuts.gbr, BILLEE_Rover_Control_Module_V1-MaskBottom.gbr, BILLEE_Rover_Control_Module_V1-MaskTop.gbr, BILLEE_Rover_Control_Module_V1-NPTH.drl]
2026-08-27 Fixed incorrect Part Mapping. Final Claude Pass/
    [BILLEE_Rover_Control_Module_V1-CuBottom.gbr, BILLEE_Rover_Control_Module_V1-CuIn1.gbr, BILLEE_Rover_Control_Module_V1-CuIn2.gbr, BILLEE_Rover_Control_Module_V1-CuTop.gbr, BILLEE_Rover_Control_Module_V1-EdgeCuts.gbr, BILLEE_Rover_Control_Module_V1-MaskBottom.gbr, BILLEE_Rover_Control_Module_V1-MaskTop.gbr, BILLEE_Rover_Control_Module_V1-NPTH.drl]
2026-08-27 Updated Arm/Science rails to be 22.2V not 14.4V. this was a wrong architectural decision that needed updating.
    [BILLEE_Rover_Control_Module_V1-CuBottom.gbr, BILLEE_Rover_Control_Module_V1-CuIn1.gbr, BILLEE_Rover_Control_Module_V1-CuIn2.gbr, BILLEE_Rover_Control_Module_V1-CuTop.gbr, BILLEE_Rover_Control_Module_V1-EdgeCuts.gbr, BILLEE_Rover_Control_Module_V1-MaskBottom.gbr, BILLEE_Rover_Control_Module_V1-MaskTop.gbr, BILLEE_Rover_Control_Module_V1-NPTH.drl]
2026-08-28 Updated Block Diagrams
    [BILLEE_Rover_Control_Module_V1.kicad_sch]
2026-09-04 Final Board: Updated Gerbers and BOM
    Fixed USB C connector that was recessed. THis is the final board order file
    [BILLEE_Rover_Control_Module_V1-CuBottom.gbr, BILLEE_Rover_Control_Module_V1-CuIn1.gbr, BILLEE_Rover_Control_Module_V1-CuIn2.gbr, BILLEE_Rover_Control_Module_V1-CuTop.gbr, BILLEE_Rover_Control_Module_V1-EdgeCuts.gbr, BILLEE_Rover_Control_Module_V1-MaskBottom.gbr, BILLEE_Rover_Control_Module_V1-MaskTop.gbr, BILLEE_Rover_Control_Module_V1-NPTH.drl]
2026-09-04 Final Final Gerbers + BOM
    Moved USBC a little to the right for clearance. This is the final board.
    [BILLEE_Rover_Control_Module_V1-CuBottom.gbr, BILLEE_Rover_Control_Module_V1-CuIn1.gbr, BILLEE_Rover_Control_Module_V1-CuIn2.gbr, BILLEE_Rover_Control_Module_V1-CuTop.gbr, BILLEE_Rover_Control_Module_V1-EdgeCuts.gbr, BILLEE_Rover_Control_Module_V1-MaskBottom.gbr, BILLEE_Rover_Control_Module_V1-MaskTop.gbr, BILLEE_Rover_Control_Module_V1-NPTH.drl]
2026-09-04 Created BILLEE Science Module folders and files
    [BILLEE_Science_Control_Module_V1.kicad_pcb, BILLEE_Science_Control_Module_V1.kicad_sch]
